Hauke12345/Boili/hardware/pcb/docs/spot_heater-3d-top.png

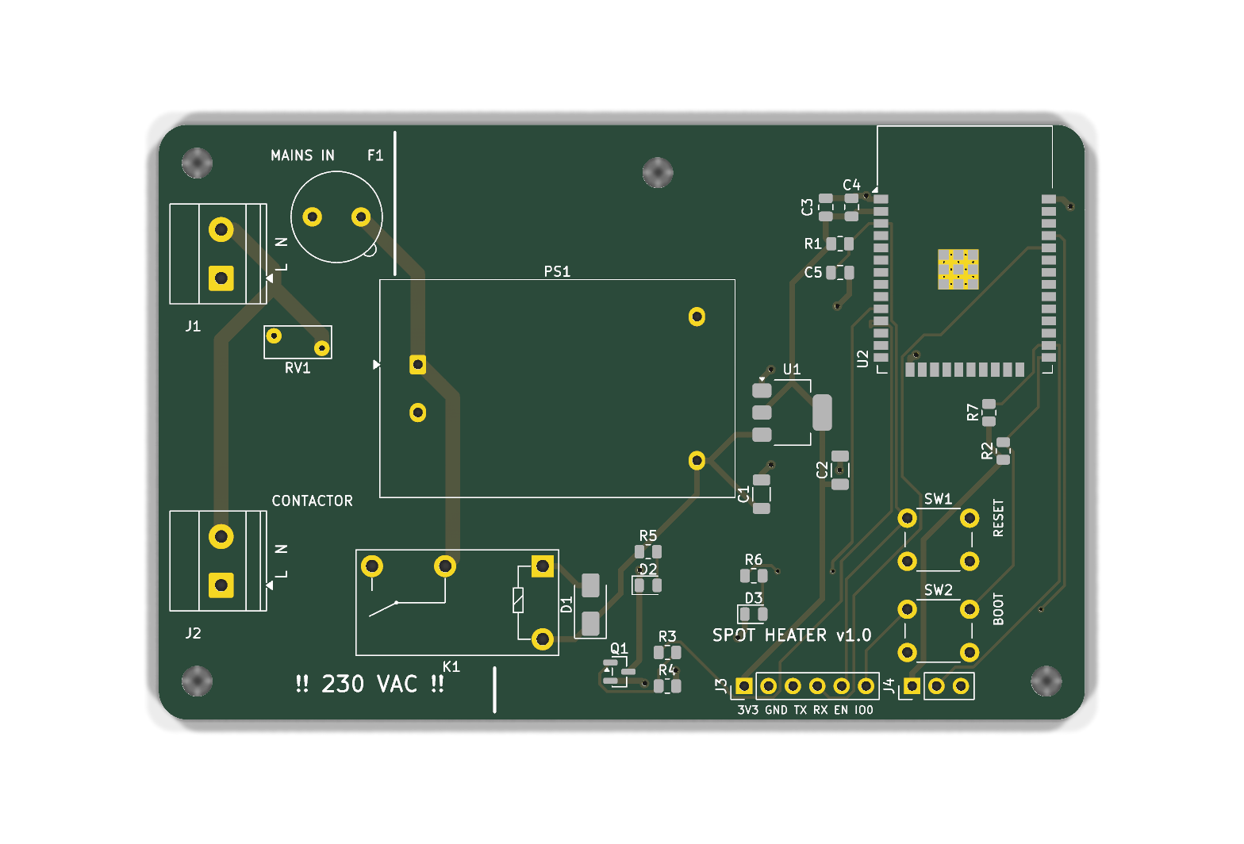
hardware/pcb/docs/spot_heater-3d-top.png
