Hauke12345/Boili/media/gifs/boili_enclosure_speedrun.gif

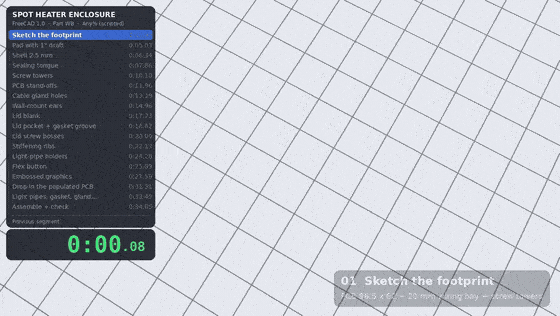
media/gifs/boili_enclosure_speedrun.gif
