Hauke12345/Boili/media/gifs/boili_enclosure_studio.gif

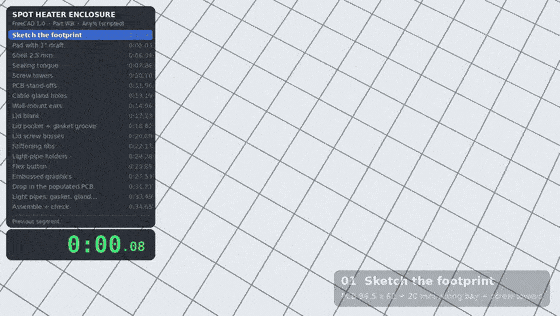
media/gifs/boili_enclosure_studio.gif
