Hauke12345/Boili/media/gifs/boili_pcb_speedrun.gif

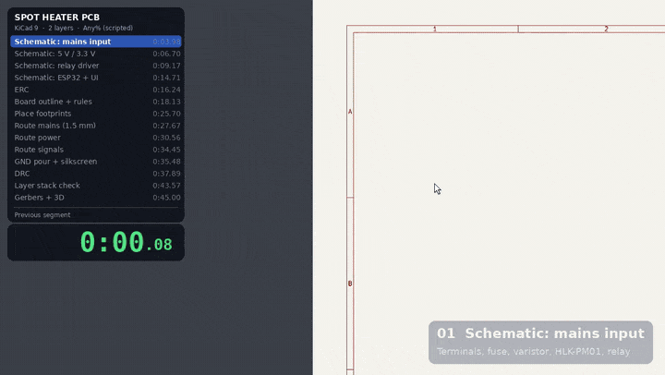
media/gifs/boili_pcb_speedrun.gif
