Hauke12345/Boili/website/media/enclosure.jpg

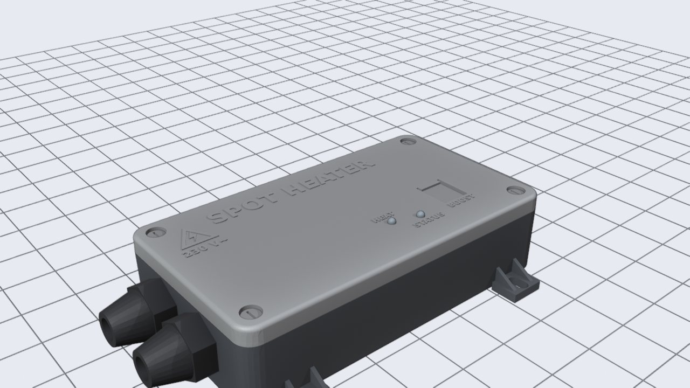
website/media/enclosure.jpg
