Hauke12345/Boili/website/media/enclosure_exploded.jpg

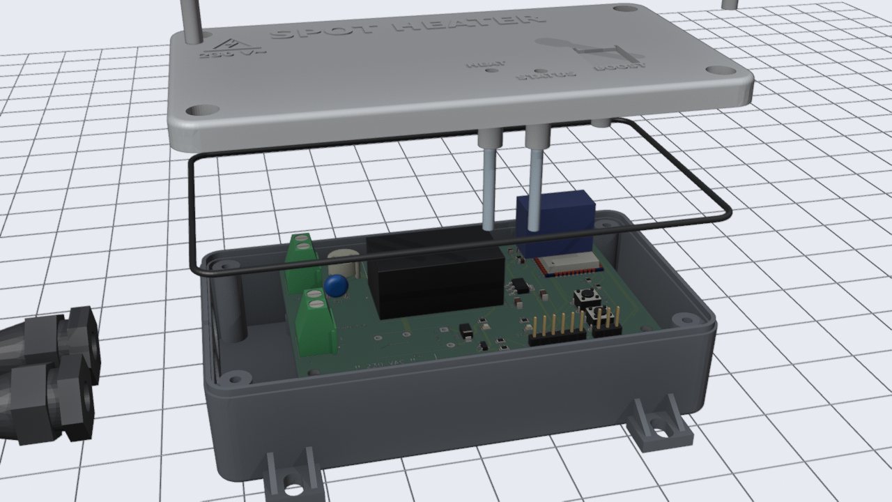
website/media/enclosure_exploded.jpg
