Hauke12345/Boili/website/media/layers.jpg

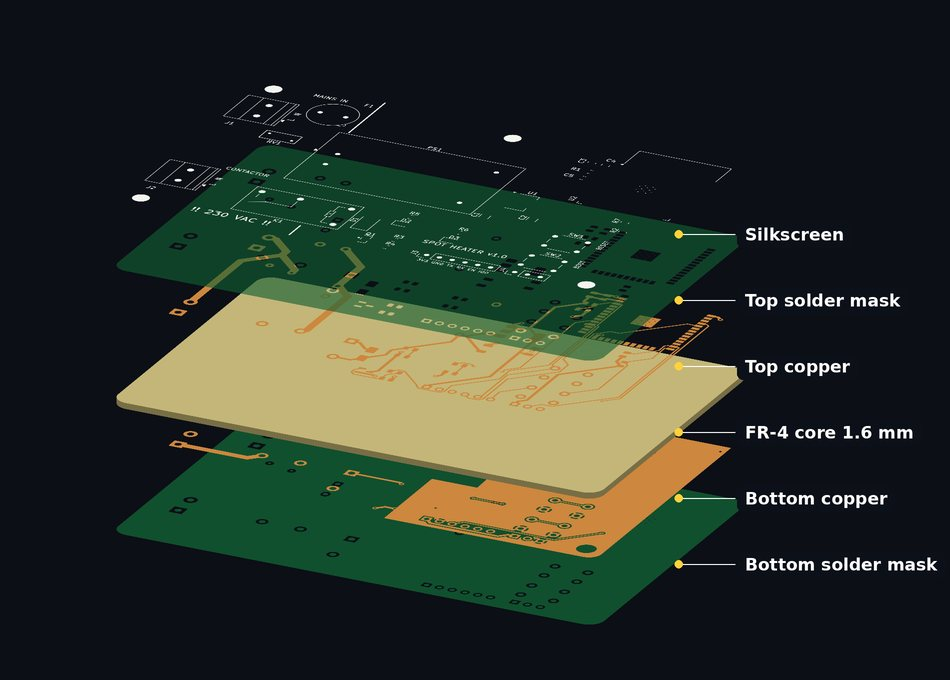
website/media/layers.jpg
