Hauke12345/Boili/website/media/pcb.jpg

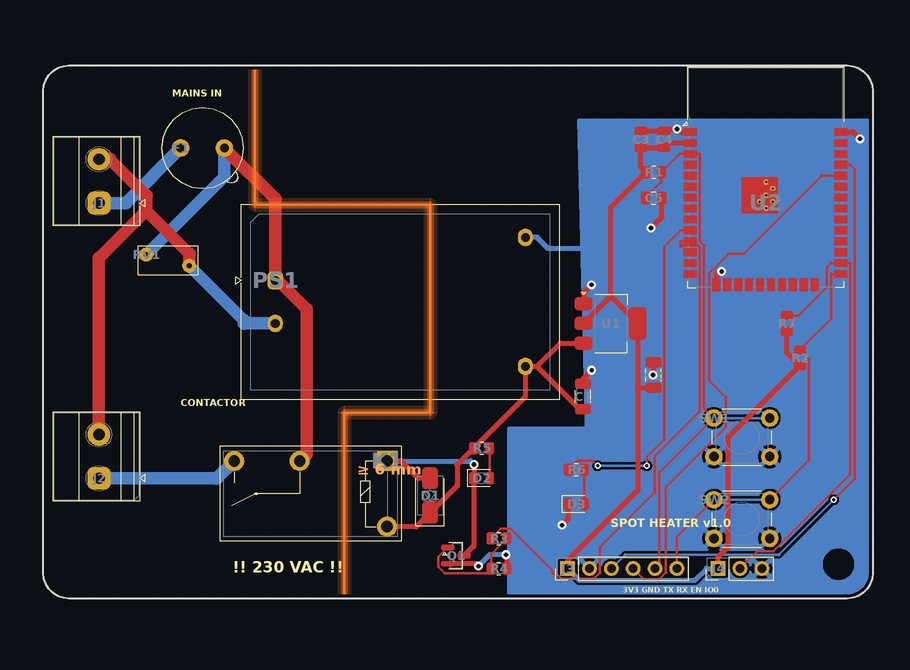
website/media/pcb.jpg
