Hauke12345/Boili/website/media/product.jpg

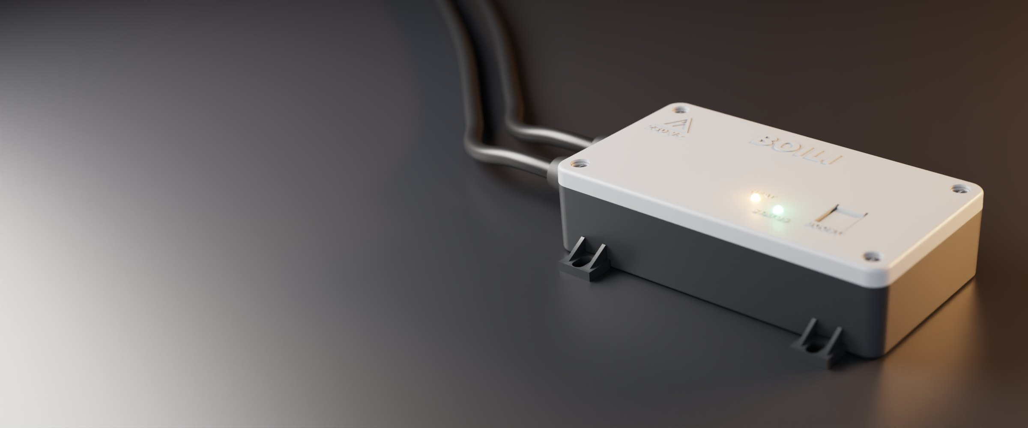
website/media/product.jpg
