Hauke12345/Boili/website/media/system.jpg

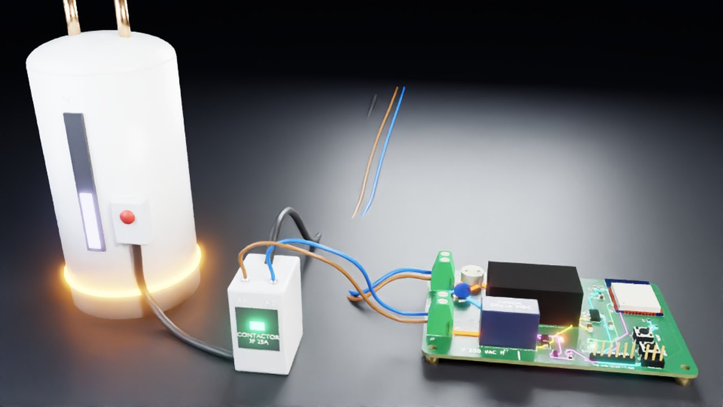
website/media/system.jpg
