Hauke12345/Boili/website/media/wifi.jpg

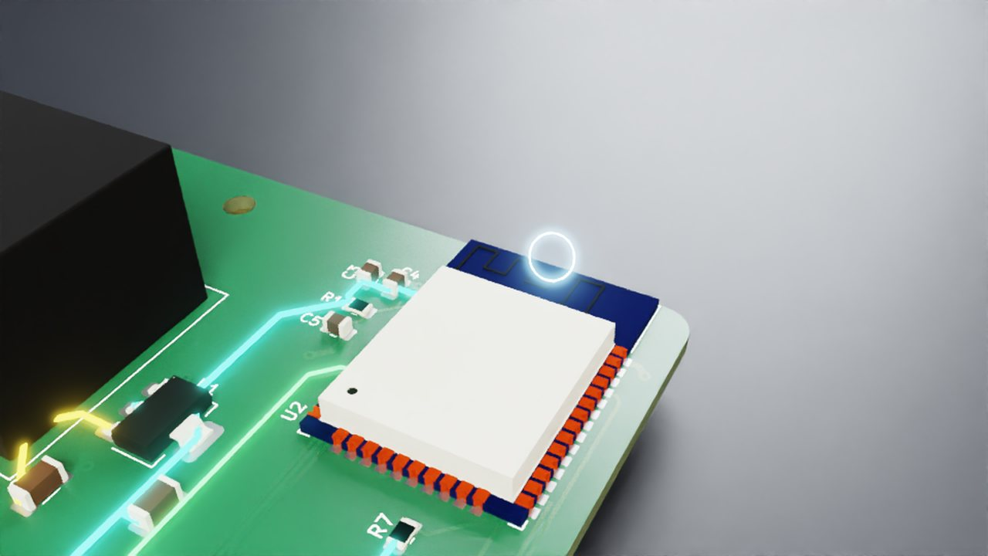
website/media/wifi.jpg
