Hauke12345/Boili/hardware/pcb/docs/spot_heater-bom.csv

Qty | Refs | Value | Footprint
2 | C1,C2 | 22uF 10V | Capacitor_SMD:C_1206_3216Metric
1 | C3 | 10uF | Capacitor_SMD:C_0805_2012Metric
1 | C4 | 100nF | Capacitor_SMD:C_0805_2012Metric
1 | C5 | 1uF | Capacitor_SMD:C_0805_2012Metric
1 | D1 | SS14 | Diode_SMD:D_SMA
1 | D2 | RED (heating) | LED_SMD:LED_0805_2012Metric
1 | D3 | GREEN (status) | LED_SMD:LED_0805_2012Metric
1 | F1 | T1A 250V (TR5) | Fuse:Fuseholder_TR5_Littelfuse_No560_No460
1 | J1 | MAINS IN (L, N) | TerminalBlock_Phoenix:TerminalBlock_Phoenix_MKDS-1,5-2-5.08_1x02_P5.08mm_Horizontal
1 | J2 | TO CONTACTOR COIL (L_SW, N) | TerminalBlock_Phoenix:TerminalBlock_Phoenix_MKDS-1,5-2-5.08_1x02_P5.08mm_Horizontal
1 | J3 | PROG | Connector_PinHeader_2.54mm:PinHeader_1x06_P2.54mm_Vertical
1 | J4 | DS18B20 | Connector_PinHeader_2.54mm:PinHeader_1x03_P2.54mm_Vertical
1 | K1 | G5Q-1A 5VDC | Relay_THT:Relay_SPST_Omron-G5Q-1A
1 | PS1 | HLK-PM01 (5V 0.6A) | Converter_ACDC:Converter_ACDC_Hi-Link_HLK-PMxx
1 | Q1 | AO3400A | Package_TO_SOT_SMD:SOT-23
2 | R1,R2 | 10k | Resistor_SMD:R_0805_2012Metric
1 | R3 | 100R | Resistor_SMD:R_0805_2012Metric
1 | R4 | 100k | Resistor_SMD:R_0805_2012Metric
2 | R5,R6 | 1k | Resistor_SMD:R_0805_2012Metric
1 | R7 | 4k7 | Resistor_SMD:R_0805_2012Metric
1 | RV1 | 275VAC S07K275 | Varistor:RV_Disc_D7mm_W3.4mm_P5mm
1 | SW1 | RESET | Button_Switch_THT:SW_PUSH_6mm
1 | SW2 | BOOT / BOOST | Button_Switch_THT:SW_PUSH_6mm
1 | U1 | AMS1117-3.3 | Package_TO_SOT_SMD:SOT-223-3_TabPin2
1 | U2 | ESP32-WROOM-32E | RF_Module:ESP32-WROOM-32
