Hauke12345/Boili/hardware/enclosure/spot_heater_enclosure_assembly.step

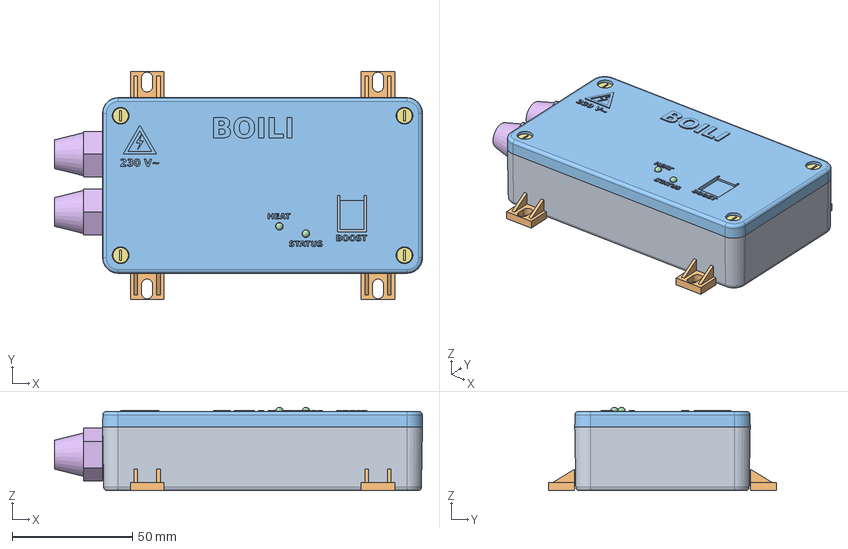
[picture p14: CAD file, 2026-10-22]
hardware/enclosure/spot_heater_enclosure_assembly.step
153.0 x 95.0 x 34.7 mm
Base
Lid
LightPipes
Gasket
CableGlands
Screws
