Hauke12345/Boili/hardware/enclosure/spot_heater_enclosure.FCStd

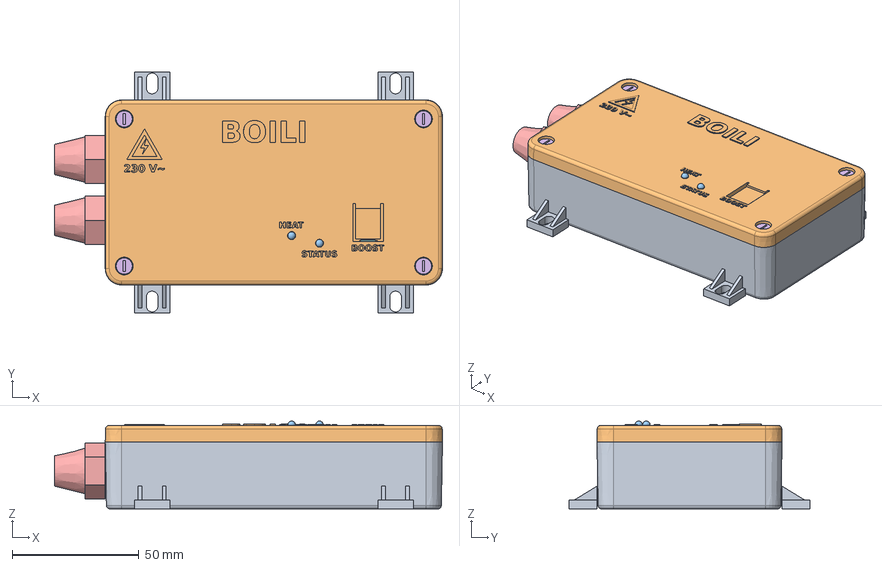
[picture p15: CAD file, 2026-10-22]
hardware/enclosure/spot_heater_enclosure.FCStd
153.0 x 95.0 x 34.7 mm
Base
Lid
LightPipes
Gasket
CableGlands
Screws
LED_0805_2012Metric
SW_PUSH_6mm
R_0805_2012Metric
D_SMA
SOT-223
R_0805_2012Metric001
C_0805_2012Metric
TerminalBlock_Phoenix_MKDS-1,5-2-5.08_1x02_P5.08mm_Horizontal
C_0805_2012Metric001
R_0805_2012Metric002
C_1206_3216Metric
SW_PUSH_6mm001
R_0805_2012Metric003
Fuseholder_TR5_Littelfuse_No560_No460
C_1206_3216Metric001
R_0805_2012Metric004
R_0805_2012Metric005
Converter_ACDC_Hi-Link_HLK-PMxx
TerminalBlock_Phoenix_MKDS-1,5-2-5.08_1x02_P5.08mm_Horizontal001
PinHeader_1x03_P2.54mm_Vertical
ESP32-WROOM-32
LED_0805_2012Metric001
C_0805_2012Metric002
SOT-23
RV_Disc_D7mm_W3.4mm_P5mm
PinHeader_1x06_P2.54mm_Vertical
R_0805_2012Metric006
spot_heater_PCB
