Hauke12345/Boili/hardware/enclosure/spot_heater_cableglands.step

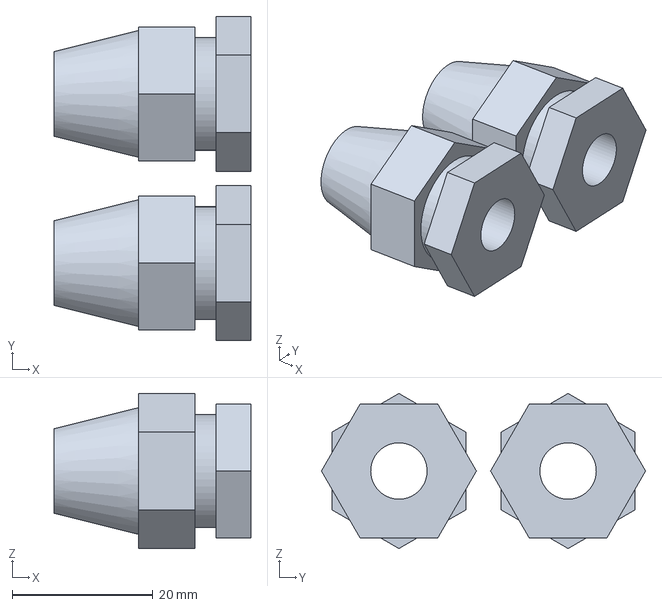
[picture p16: CAD file, 2026-10-22]
hardware/enclosure/spot_heater_cableglands.step
27.9 x 46.0 x 22.0 mm
