Hauke12345/Boili/hardware/enclosure/spot_heater_base.step

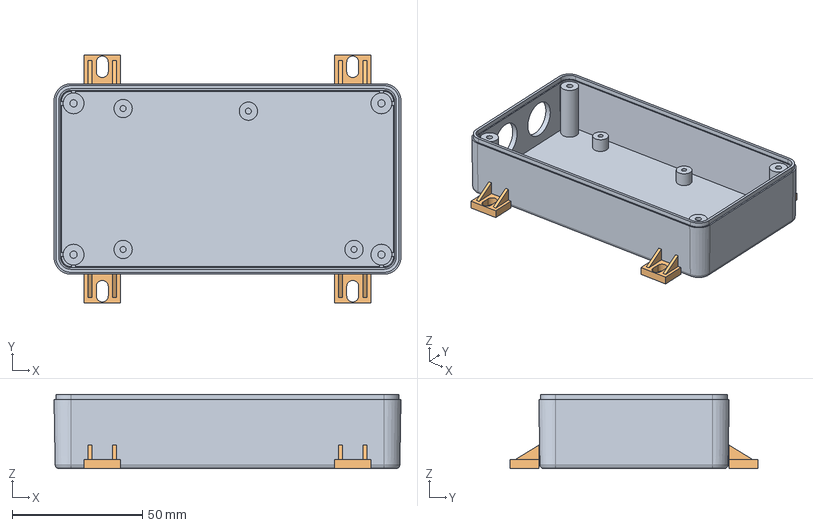
[picture p17: CAD file, 2026-10-22]
hardware/enclosure/spot_heater_base.step
133.0 x 95.0 x 28.5 mm
