Hauke12345/Boili/hardware/enclosure/spot_heater_lightpipes.step

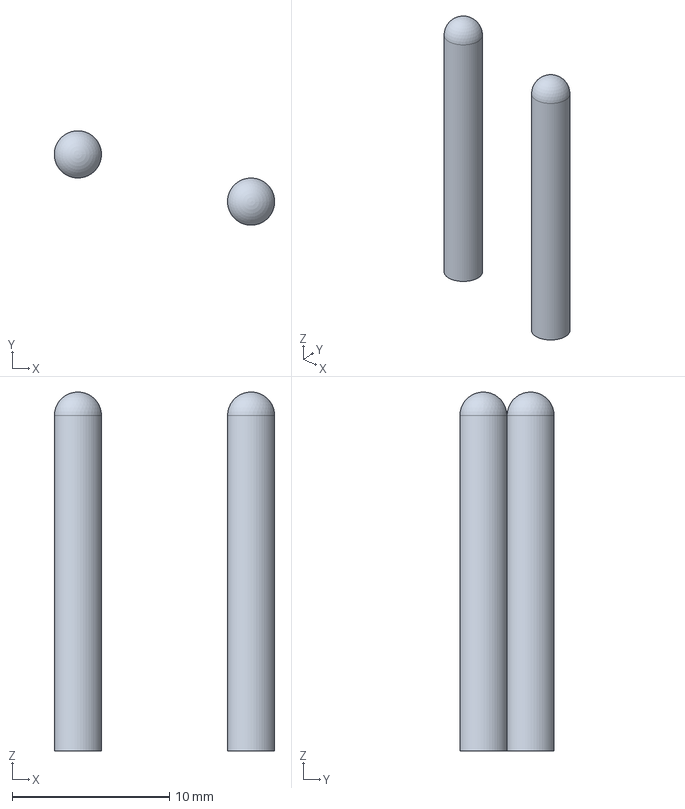
[picture p18: CAD file, 2026-10-22]
hardware/enclosure/spot_heater_lightpipes.step
14.0 x 6.00 x 22.8 mm
