Hauke12345/Boili/hardware/enclosure/spot_heater_gasket.step

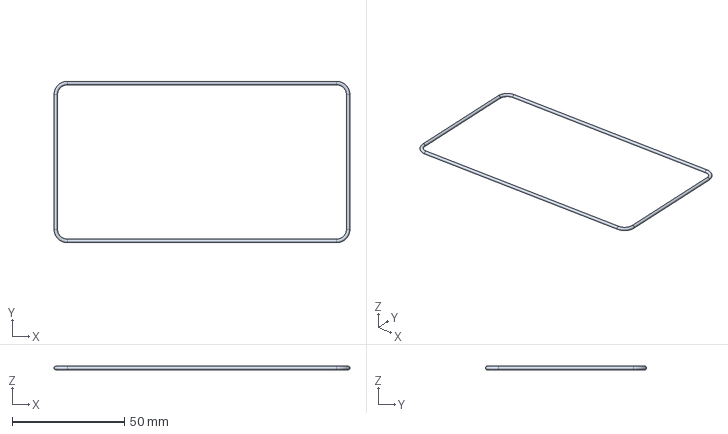
[picture p19: CAD file, 2026-10-22]
hardware/enclosure/spot_heater_gasket.step
132.0 x 72.0 x 1.60 mm
