Hauke12345/Boili/hardware/enclosure/spot_heater_lid.step

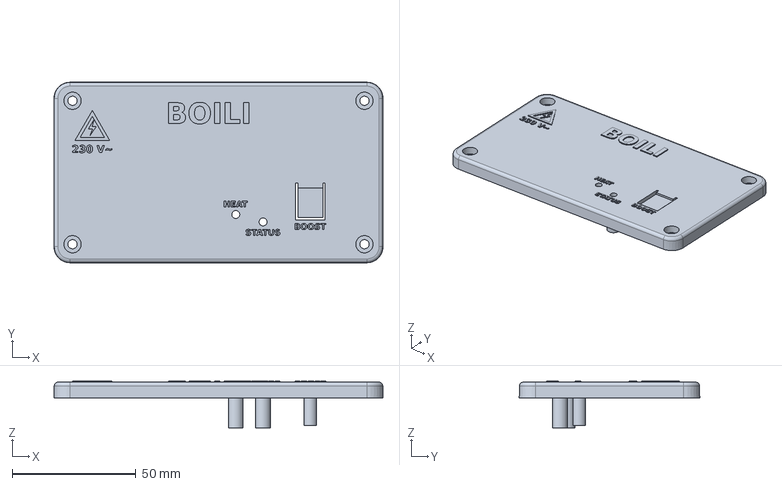
[picture p20: CAD file, 2026-10-22]
hardware/enclosure/spot_heater_lid.step
133.0 x 73.0 x 18.9 mm
