Hauke12345/Boili/hardware/enclosure/spot_heater_screws.step

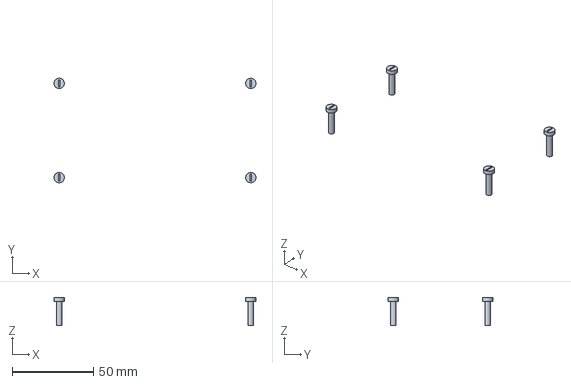
[picture p21: CAD file, 2026-10-22]
hardware/enclosure/spot_heater_screws.step
124.4 x 64.4 x 17.4 mm
