Hauke12345/Boili/(list of files, cad)

Other CAD files:
tools/enclosure_speedrun/enclosure_speedrun.blend
tools/explainer/spot_heater_explainer.blend
tools/product_renders/boili_studio.blend
tools/product_renders/boili_turntable.blend
