Hauke12345/Boili/hardware/pcb/docs/spot_heater-pcb-bottom.pdf

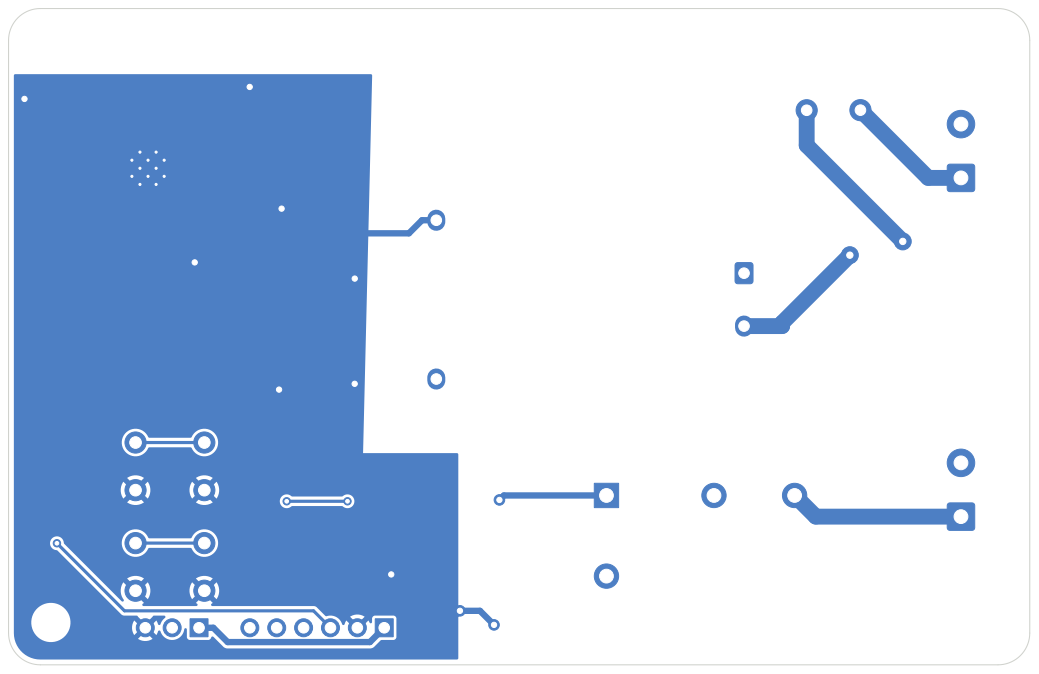
[picture p22: page 1]
