Hauke12345/Boili/hardware/pcb/docs/spot_heater-pcb-top.pdf

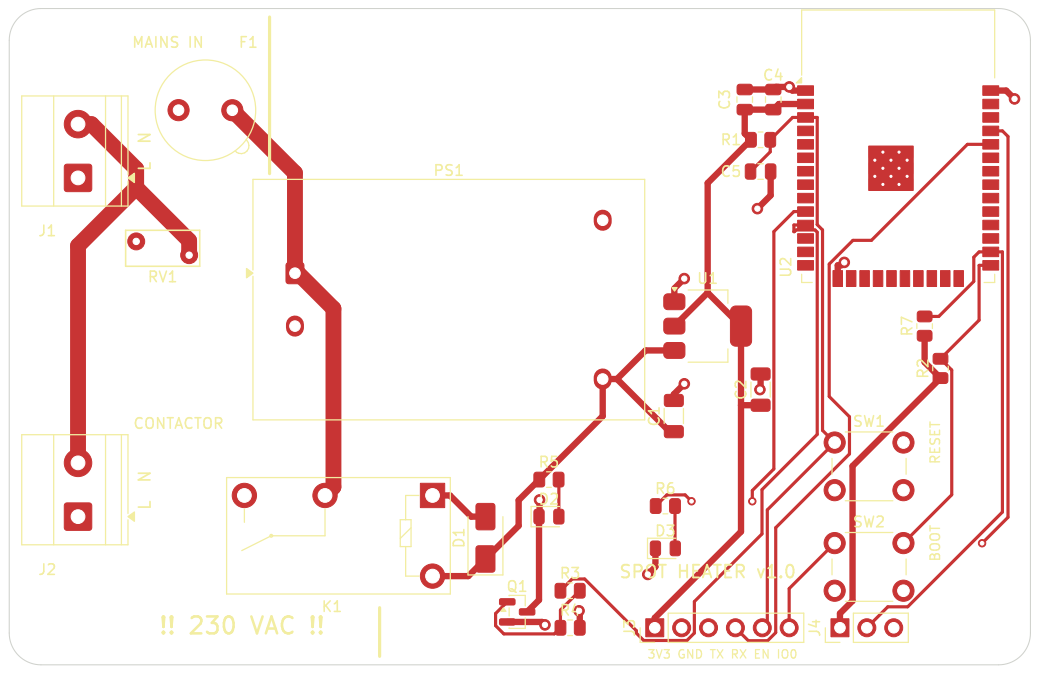
[picture p23: page 1]
