Hauke12345/Boili/hardware/pcb/docs/spot_heater-schematic.pdf

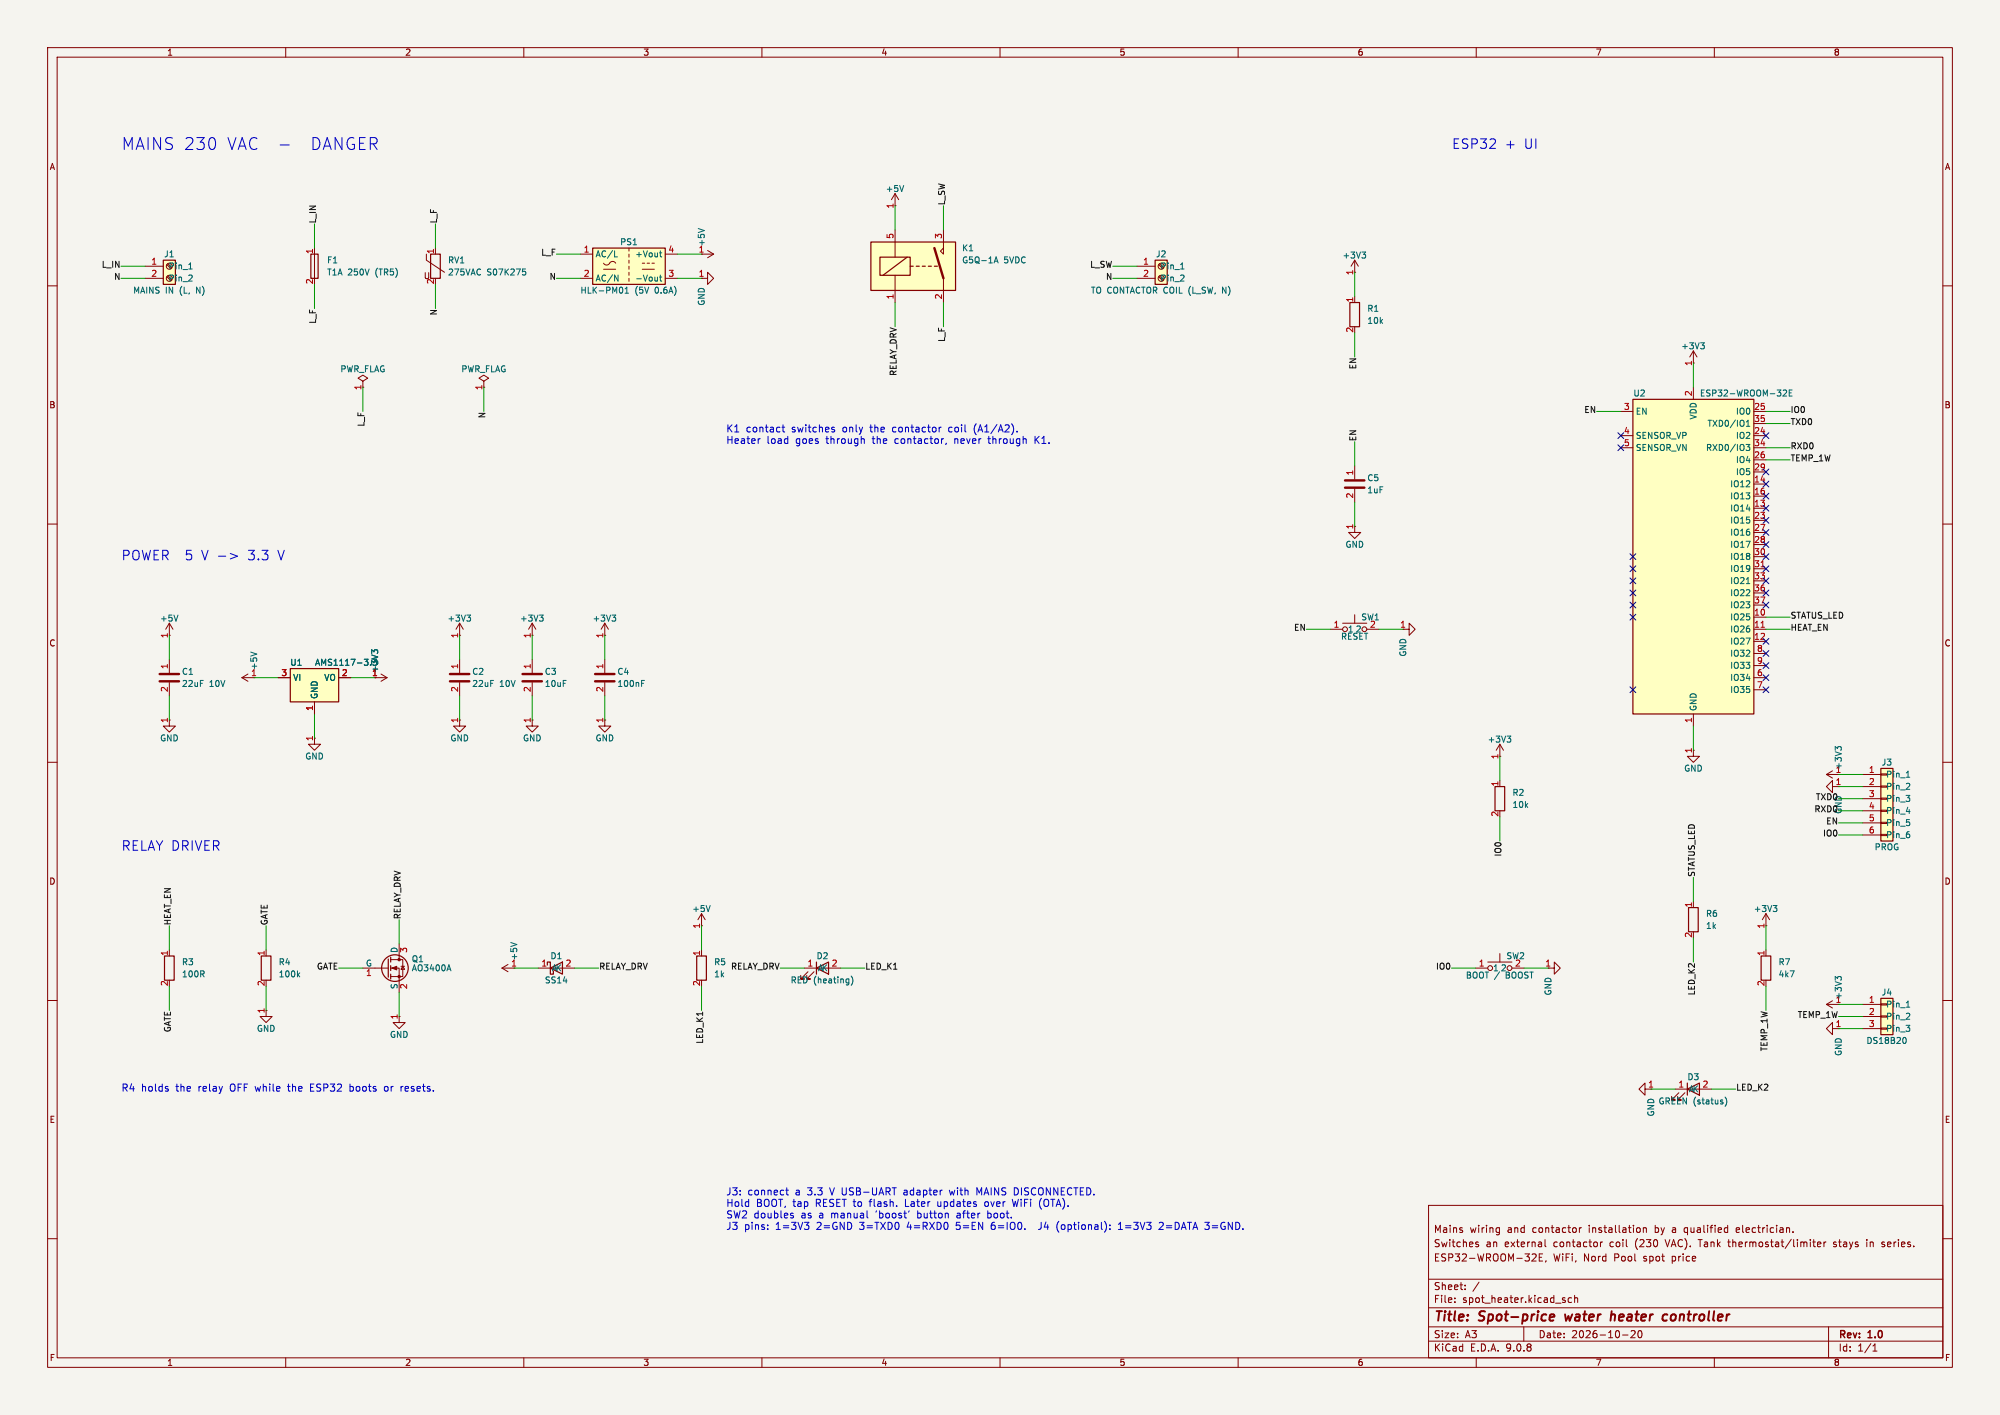
[picture p24: page 1]
