Hauke12345/Boili/(list of files, drawings)

Other design files:
tools/pcb_speedrun/sch_meta.json
