Hauke12345/Boili/hardware/pcb/spot_heater.kicad_pcb

## KiCad design hardware/pcb/spot_heater.kicad_pcb (2026-10-22)

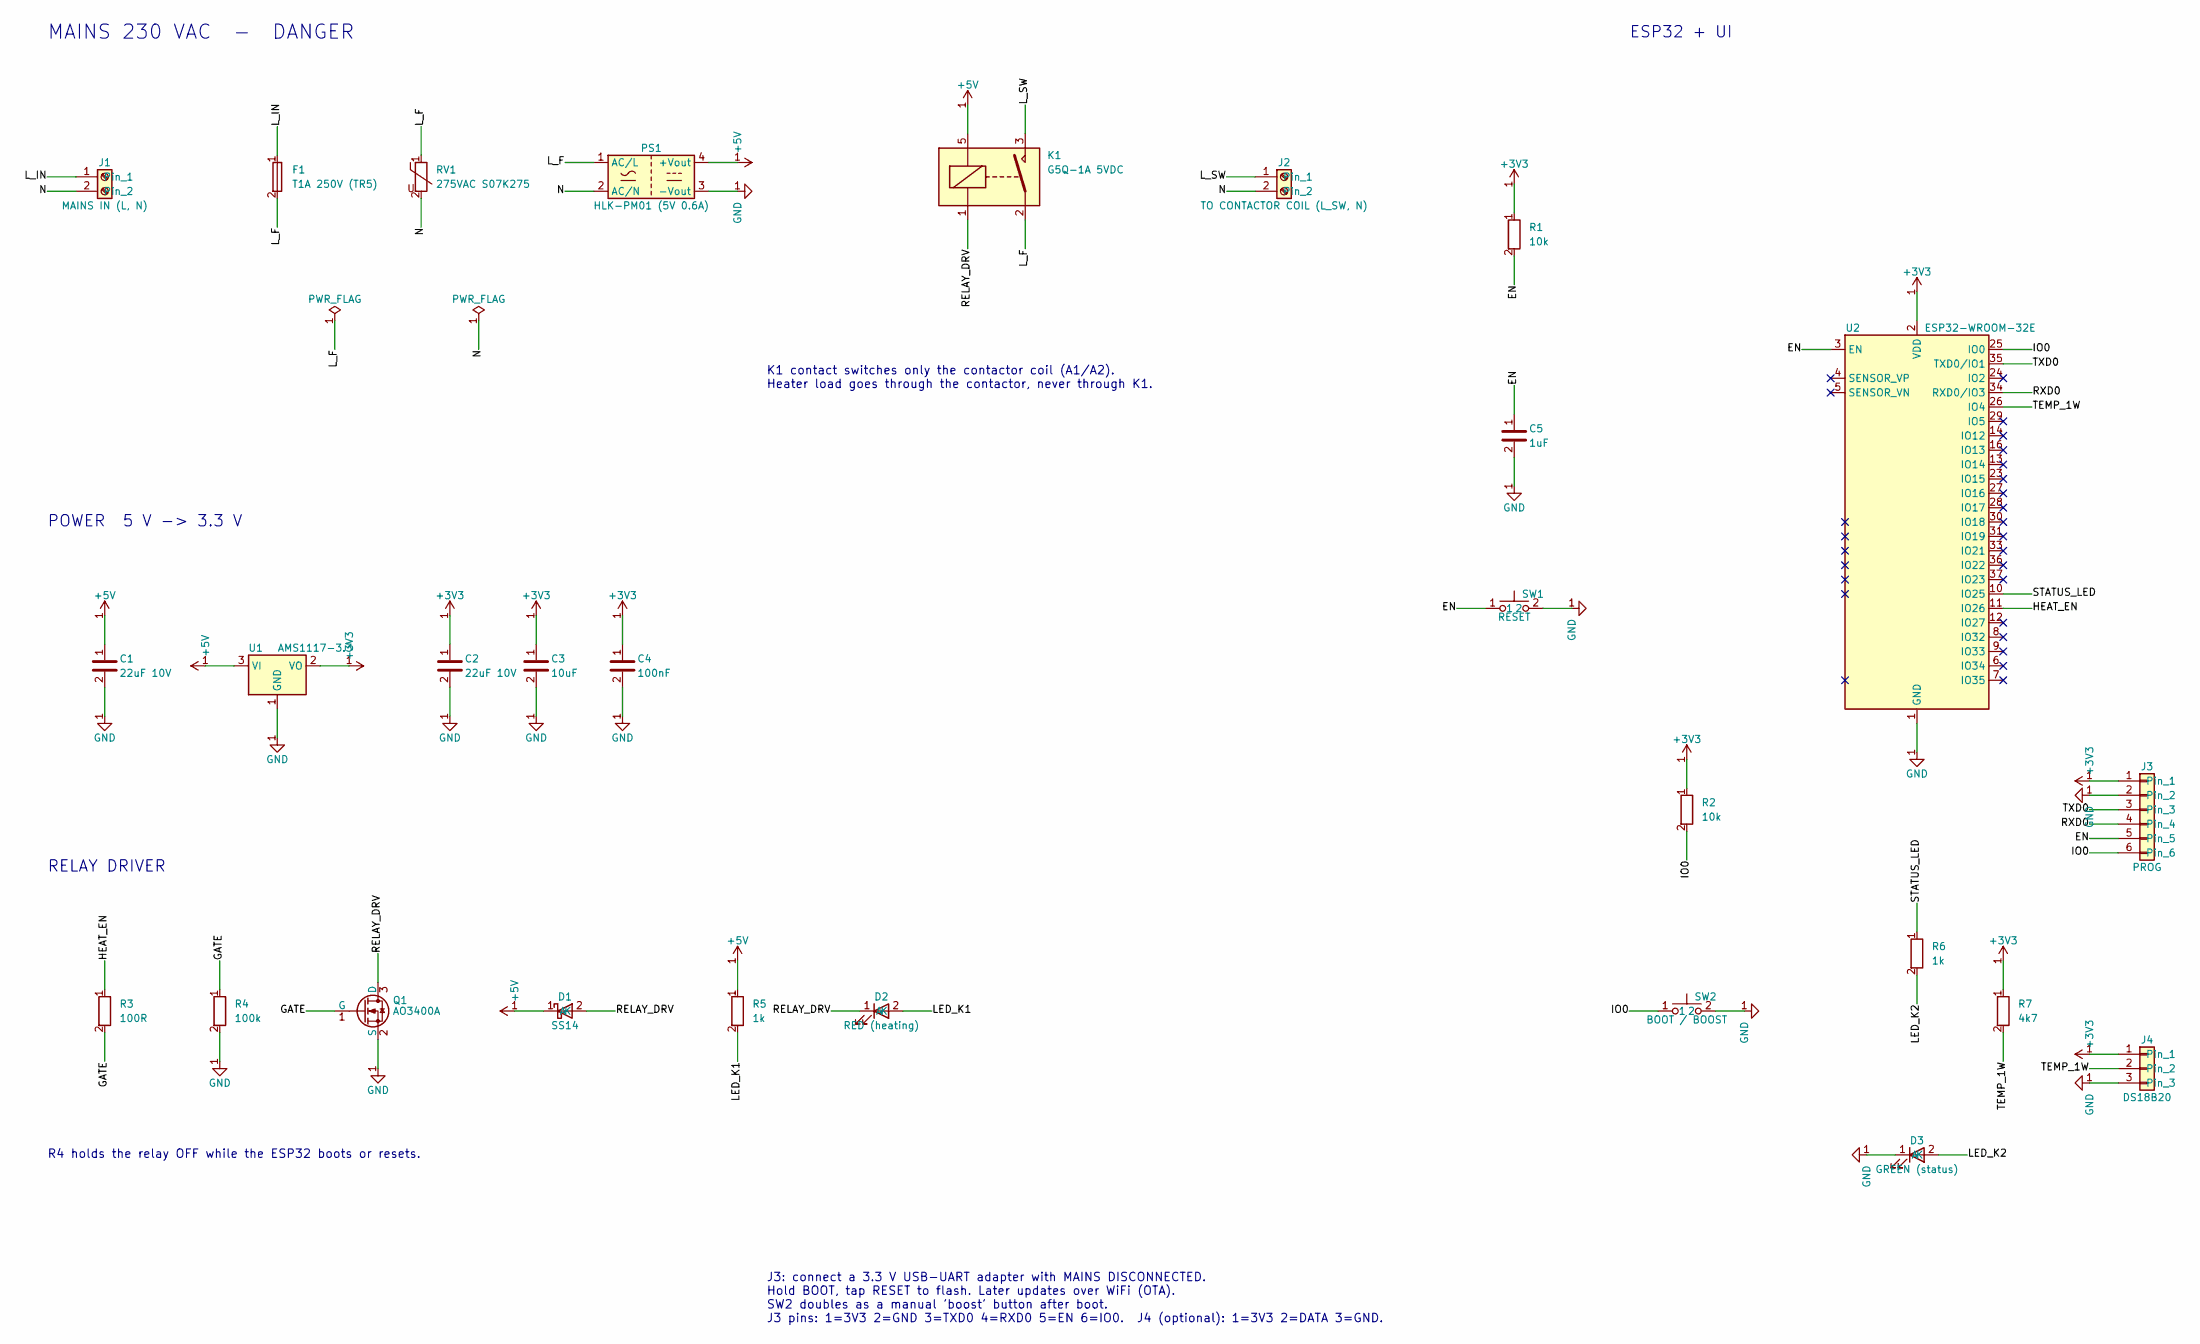
[picture p25: schematic spot_heater.kicad_sch, Spot-price water heater controller]

Parts:
C1, C2: 22uF 10V; C_1206_3216Metric
C3: 10uF; C_0805_2012Metric
C4: 100nF; C_0805_2012Metric
C5: 1uF; C_0805_2012Metric
D1: SS14; D_SMA
D2: RED (heating); LED_0805_2012Metric
D3: GREEN (status); LED_0805_2012Metric
F1: T1A 250V (TR5); Fuseholder_TR5_Littelfuse_No560_No460
J1: MAINS IN (L, N); TerminalBlock_Phoenix_MKDS-1,5-2-5.08_1x02_P5.08mm_Horizont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
J2: TO CONTACTOR COIL (L_SW, N); TerminalBlock_Phoenix_MKDS-1,5-2-5.08_1x02_P5.08mm_Horizont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
J3: PROG; PinHeader_1x06_P2.54mm_Vertical
J4: DS18B20; PinHeader_1x03_P2.54mm_Vertical
K1: G5Q-1A 5VDC; Relay_SPST_Omron-G5Q-1A
PS1: HLK-PM01 (5V 0.6A); Converter_ACDC_Hi-Link_HLK-PMxx
Q1: AO3400A; SOT-23
R1, R2: 10k; R_0805_2012Metric
R3: 100R; R_0805_2012Metric
R4: 100k; R_0805_2012Metric
R5, R6: 1k; R_0805_2012Metric
R7: 4k7; R_0805_2012Metric
RV1: 275VAC S07K275; RV_Disc_D7mm_W3.4mm_P5mm
SW1: RESET; SW_PUSH_6mm
SW2: BOOT / BOOST; SW_PUSH_6mm
U1: AMS1117-3.3; SOT-223-3_TabPin2
U2: ESP32-WROOM-32E; ESP32-WROOM-32

Connections:
+3V3: C2.1, C3.1, C4.1, J3.1, J4.1, R1.1, R2.1, R7.1, U1.2 (VO), U2.2 (VDD)
+5V: C1.1, D1.1 (K), K1.5, PS1.4 (+Vout), R5.1, U1.3 (VI)
/EN: C5.1, J3.5, R1.2, SW1.1, U2.3 (EN)
/GATE: Q1.1 (G), R3.2, R4.1
/HEAT_EN: R3.1, U2.11 (IO26)
/IO0: J3.6, R2.2, SW2.1, U2.25 (IO0)
/LED_K1: D2.2 (A), R5.2
/LED_K2: D3.2 (A), R6.2
/L_F: F1.2, K1.2, PS1.1 (AC/L), RV1.1
/L_IN: F1.1, J1.1
/L_SW: J2.1, K1.3
/N: J1.2, J2.2, PS1.2 (AC/N), RV1.2
/RELAY_DRV: D1.2 (A), D2.1 (K), K1.1, Q1.3 (D)
/RXD0: J3.4, U2.34 (RXD0/IO3)
/STATUS_LED: R6.1, U2.10 (IO25)
/TEMP_1W: J4.2, R7.2, U2.26 (IO4)
/TXD0: J3.3, U2.35 (TXD0/IO1)
GND: C1.2, C2.2, C3.2, C4.2, C5.2, D3.1 (K), J3.2, J4.3, PS1.3 (-Vout), Q1.2 (S), R4.2, SW1.2, SW2.2, U1.1 (GND), U2.1 (GND), U2.15 (GND), U2.38 (GND), U2.39 (GND)

Notes on the sheet:
MAINS 230 VAC - DANGER
K1 contact switches only the contactor coil (A1/A2). Heater load goes through the contactor, never through K1.
POWER 5 V -> 3.3 V
RELAY DRIVER
R4 holds the relay OFF while the ESP32 boots or resets.
ESP32 + UI
J3: connect a 3.3 V USB-UART adapter with MAINS DISCONNECTED. Hold BOOT, tap RESET to flash. Later updates over WiFi (OTA). SW2 doubles as a manual 'boost' button after boot. J3 pins: 1=3V3 2=GND 3=TXD0 4=RXD0 5=EN 6=IO0. J4 (optional): 1=3V3 2=DATA 3=GND.

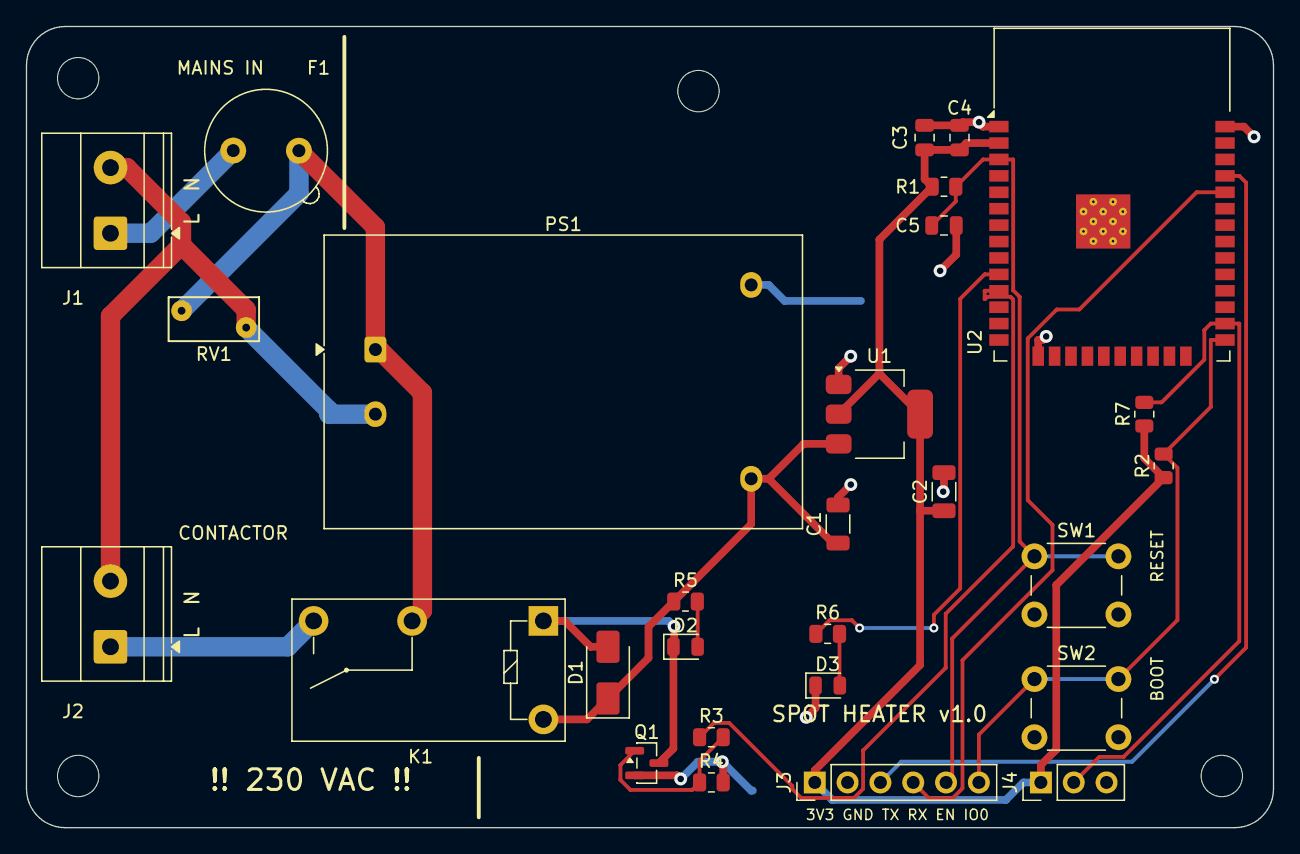
[picture p26: board spot_heater.kicad_pcb from above]

Board: 2 copper layers, 96.5 x 62.0 mm, 32 parts (0 on the bottom side), 18 nets.

Other parts of the board:
H1, H2, H3, H4: M3; MountingHole_3.2mm_M3
