Hauke12345/Boili/(commit log)

2026-10-22 Add Boili design files: KiCad PCB, FreeCAD enclosure, mock-up website, render tools
    Claude-Session: https://claude.ai/code/session_0183GvN3NLq2xGwTm8DVweVP
    [boili_studio.blend, boili_turntable.blend, enclosure_speedrun.blend, sch_meta.json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]
2026-10-22 Add SPICE simulation of the Boili PCB
    ngspice checks of the relay driver at worst-case corners, boot behaviour,
    3.3 V / 5 V rails under ESP32 WiFi TX bursts, and power-up sequencing.
    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
